exclamationMarek/skeuomorphicer-candle-sao/kicad/sao_candle.kicad_pcb

## KiCad design kicad/sao_candle.kicad_pcb (2026-05-16)

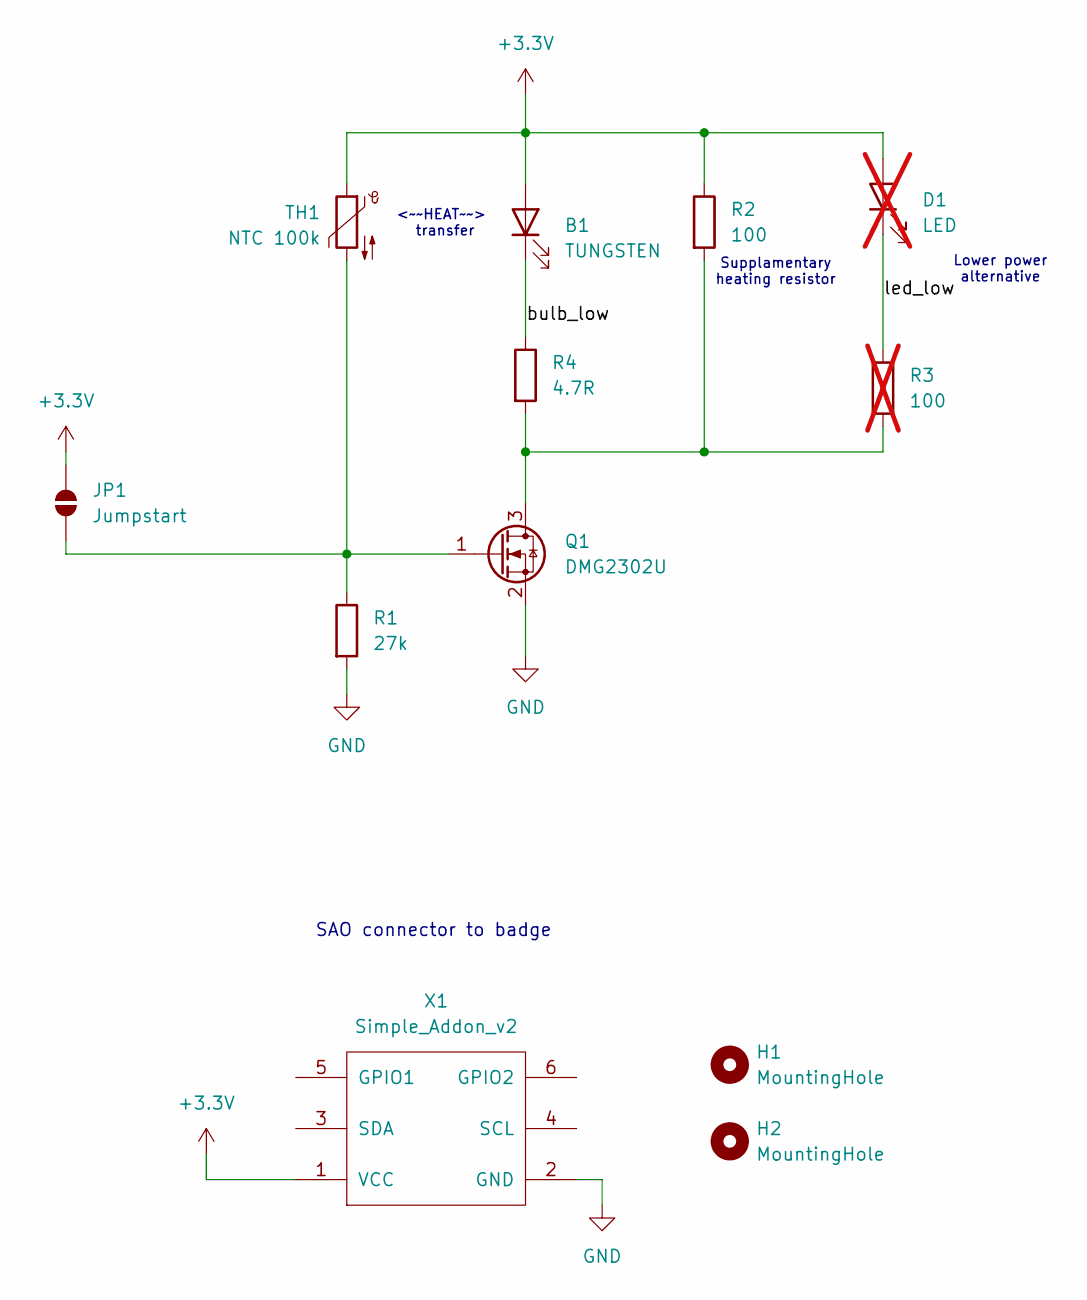
[picture p3: schematic sao_candle.kicad_sch]

Parts:
B1: TUNGSTEN; LED_Rectangular_W3.9mm_H1.9mm
D1: LED; R_0603_1608Metric; not fitted
H1, H2: MountingHole; MountingHole_2.2mm_M2
JP1: Jumpstart; SolderJumper-2_P1.3mm_Open_RoundedPad1.0x1.5mm
Q1: DMG2302U; SOT-23_Handsoldering
R1: 27k; R_0603_1608Metric_Pad0.98x0.95mm_HandSolder
R2: 100; R_0603_1608Metric
R3: 100; R_0603_1608Metric_Pad0.98x0.95mm_HandSolder; not fitted
R4: 4.7R; R_0603_1608Metric_Pad0.98x0.95mm_HandSolder
TH1: NTC 100k; R_0603_1608Metric
X1: Simple_Addon_v2; Simple_Addon_v2-SAO-2x3

Connections:
+3.3V: B1.2 (A), D1.2 (A), JP1.2 (B), R2.1, TH1.1, X1.1 (VCC)
/bulb_low: B1.1 (K), R4.1
/led_low: D1.1 (K), R3.1
GND: Q1.2 (S), R1.2, X1.2 (GND)
unnamed: JP1.1 (A), Q1.1 (G), R1.1, TH1.2
unnamed: Q1.3 (D), R2.2, R3.2, R4.2

Notes on the sheet:
Supplamentary heating resistor
<~~HEAT~~> transfer
Lower power alternative
SAO connector to badge

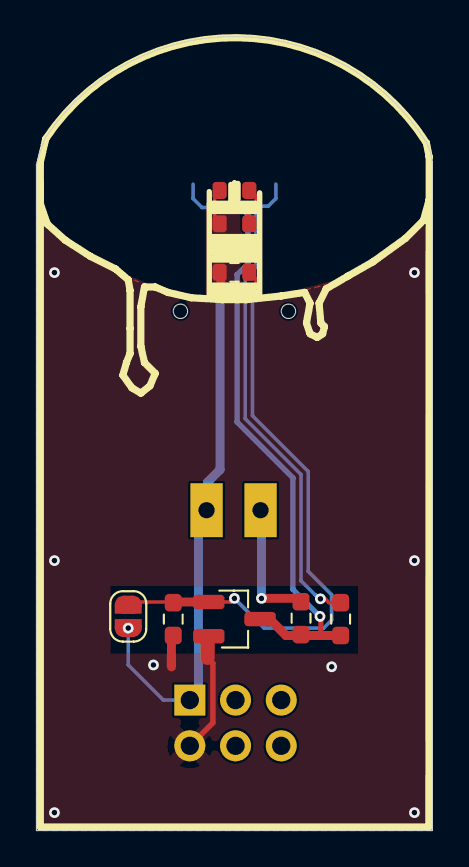
[picture p4: board sao_candle.kicad_pcb from above]

Board: 2 copper layers, 22.0 x 44.1 mm, 12 parts (0 on the bottom side), 6 nets.
